DeeKahy/Pollen-Detector/report/figures/flourtest-green-crop.jpg

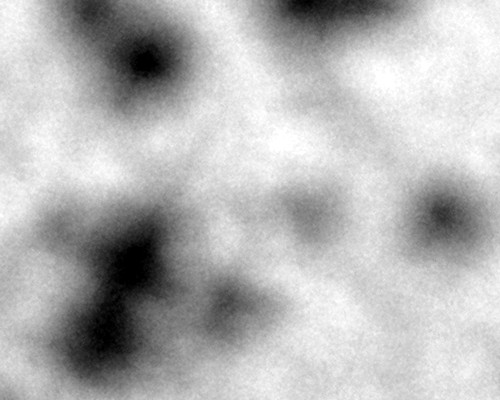
report/figures/flourtest-green-crop.jpg
