DeeKahy/Pollen-Detector/report/chapters/1.0-introduction.tex

\chapter{Introduction}\label{ch:introduction}
% Draft by Claude from the earlier introduction and our notes, edit freely.
% Red text: \fillin = write or decide now, \future = can only be done later.

Pollen allergy affects a large share of the population. For many people the symptoms follow
the day-to-day amount of pollen in the air around them. In Denmark the daily pollen counts
come from two stations, one in Copenhagen for eastern Denmark and one in Viborg for western
Denmark~\cite{AstmaAllergi}. Pollen levels for other places are estimates based on the nearest
station, so they show a general trend rather than a local measurement
\fillin{source for this, e.g. the Astma-Allergi Danmark page that says so}. Pollen levels change
with local plants, terrain and weather, so a person living far from a station can have quite
different conditions from the published numbers.

\section{How pollen is measured today}

The stations use a volumetric trap of the Hirst type~\cite{Hirst1952,EN16868}. A pump pulls
air through a narrow slit onto a sticky tape on a slowly turning drum. Once a week the tape is
taken out, stained and counted by hand under a microscope by a trained person. The method is
the reference standard and works well, but it has two problems for local information:

\begin{itemize}
  \item \textbf{Cost.} The traps and the trained staff are expensive, so there are only two
  stations. \fillin{Price of a trap, with a source. Burkard does not list prices; ask Florian or
  Astma-Allergi Danmark, or find a tender document.}
  \item \textbf{Manual work.} Every count is done by a trained person, which limits how many
  samples can be analysed~\cite{Tummon2024}. \fillin{Florian told us this. Check that
  Tummon et al.\ 2024 says it, or find a better source.}
\end{itemize}

Automated monitors exist, such as the Swisens Poleno Jupiter~\cite{SwisensPoleno}. They identify
pollen without a person, but they are specialised instruments with a price far above what a
dense network can afford. Research prototypes show that cheap optics can work: Wu et
al.~\cite{Wu2018} used a phone-based microscope without a lens and deep learning to recognise
pollen and spores.

\section{Idea: a pollen monitor anyone can build}

For fine dust the problem has already been solved in a different way. Sensor.Community (started
as luftdaten.info in Stuttgart) lets anyone build a cheap particle sensor from a guide, put it
outside and share the data on a public map~\cite{SensorCommunity}. Thousands of these sensors
now give much more local data than the official stations. No similar low-cost, open approach
exists for pollen, because a particle counter cannot tell pollen types apart.

Our idea is to do the same for pollen. The device should be cheap enough (around 100 to 150
euro) and simple enough that anyone can build one from a guide. Like the reference trap it
catches particles on sticky tape, but instead of a person with a microscope, a camera takes
pictures of the tape and software counts the pollen by type.

We see two kinds of users:

\begin{itemize}
  \item \textbf{People and communities} who build a station at home. All stations send their
  counts to a shared server, which can combine them into a local pollen map or forecast, like a
  weather forecast.
  \item \textbf{The people running the current stations}, who could set up some of our stations
  around the country. Each station should hopefully only need a new roll of tape every few weeks or months,
  and a check against a reference trap now and then to stay calibrated.
\end{itemize}

We think all of it should be free: the design, the software and the data. The software is
open source (AGPL-3.0) and the 3D models are public domain (CC0).
\fillin{Licence for the report, photos and collected data?}

This project builds on an earlier open-source pollen detector by
\fillin{Florian's full name and reference}. We designed our own 3D-printed parts from scratch,
to make the device easier to build, but the electronics and the basic way it works (a fan, a
tape moved by a stepper motor, and a Raspberry Pi camera) follow his design. The main
addition so far is a colour LED for lighting the tape.

\section{Research question}\label{sec:research-question}

We want to find out whether this is possible at all, and how far it can go. Our main question is:

\begin{quote}
\textit{How far can a cheap, open, self-built device go towards automated pollen monitoring
that anyone can build?}
\end{quote}

To answer it we split it into smaller questions:

\begin{enumerate}
  \item Can the device catch pollen-sized particles from the air on tape?
  \item Can a cheap camera without a lens show those particles well enough to recognise them?
  \item What does a station cost, and how much upkeep does it need (tape, cleaning, calibration)?
\end{enumerate}

\section{This report}

The project runs over two semesters. This report covers the first semester: the physical
device, the electronics, the first imaging tests and the control software. Next semester a
second report covers recognising pollen in the pictures, and the two reports will be turned
into a paper.

Chapter~\ref{ch:prototype} describes the prototype as it is now, what we did and why.
\fillin{Add the remaining chapters when they exist (discussion, conclusion).}
