DeeKahy/Pollen-Detector/report/frontmatter/titlepages.tex

\pdfbookmark[0]{English title page}{label:titlepage_en}
\aautitlepage{%
  \englishprojectinfo{
    Pollen Detector %title
  }{%
    \fillin{Semester theme} %theme
  }{%
    \fillin{Fall semester 2026} %project period
  }{%
    \fillin{Group} % project group
  }{%
    %list of group members
    Lennart Diego Kahn\\
    Allias Ghorbani
  }{%
    %list of supervisors
    \fillin{Florian, full name}
  }{%
    1 % number of printed copies
  }{%
    \today % date of completion
  }%
}{%department and address
  \textbf{Electronics and IT}\\
  Aalborg University\\
  \href{http://www.aau.dk}{http://www.aau.dk}
}{% the abstract
  \fillin{Abstract. Write it last: the problem, what we built, what we found, what comes next.}
}

\cleardoublepage
{\selectlanguage{danish}
\pdfbookmark[0]{Danish title page}{label:titlepage_da}
\aautitlepage{%
  \danishprojectinfo{
    Pollendetektor %title
  }{%
    \fillin{Semestertema} %theme
  }{%
    \fillin{Efterårssemestret 2026} %project period
  }{%
    \fillin{Group} % project group
  }{%
    %list of group members
    Lennart Diego Kahn\\
    Allias Ghorbani
  }{%
    %list of supervisors
    \fillin{Florian, fulde navn}
  }{%
    1 % number of printed copies
  }{%
    \today % date of completion
  }%
}{%department and address
  \textbf{Elektronik og IT}\\
  Aalborg Universitet\\
  \href{http://www.aau.dk}{http://www.aau.dk}
}{% the abstract
  \fillin{Resumé (dansk version af abstract)}
}}
