DeeKahy/Pollen-Detector/hardware/tape-deck/renders/tower_back.png

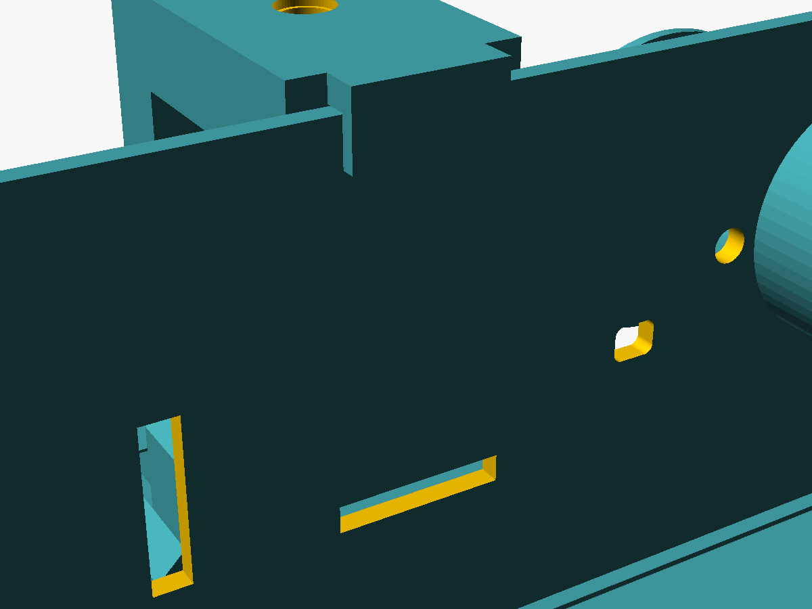
hardware/tape-deck/renders/tower_back.png
