DeeKahy/Pollen-Detector/iterations/v0-concept/camera-settings-2026-10-26/pictures/05.jpg

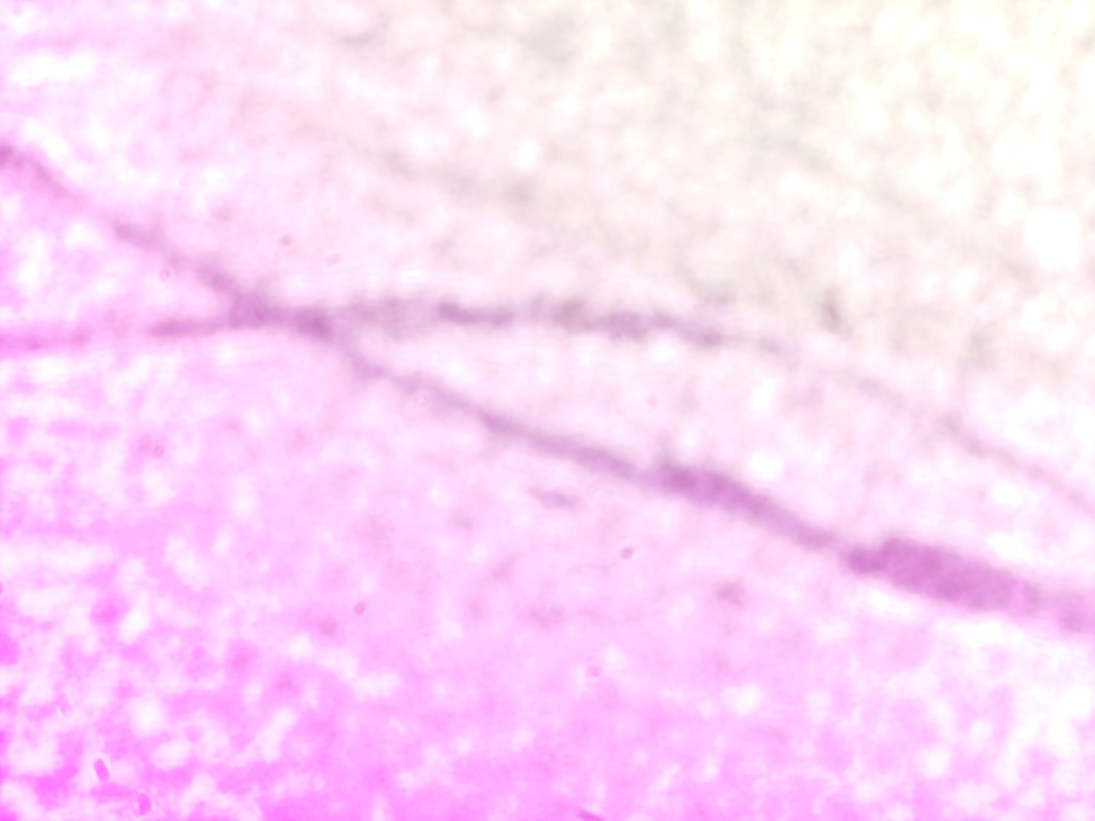
iterations/v0-concept/camera-settings-2026-10-26/pictures/05.jpg
