DeeKahy/Pollen-Detector/hardware/bom.md

# Parts list

Prices are rough, to give an idea of the total. Shop around.

## Electronics

| Part | How many | About | Notes |
|---|---|---|---|
| Raspberry Pi 3 B+ | 1 | €40 | A Pi 4 or 5 also works |
| Raspberry Pi HQ Camera (IMX477) | 1 | €55 | Used without a lens |
| Camera ribbon cable | 1 | | Comes with the camera. Longer ones (30-50 cm) are sold separately |
| 28BYJ-48 5 V stepper motor + ULN2003 driver board | 1 | €4 | Usually sold together |
| 5 V fan (brushless) | 1 | €5 | We use a JZK sleeve bearing fan |
| Logic-level N-MOSFET (IRLZ44N or AO3400) | 1 | €1 | Switches the fan. Not the blue IRF520 boards |
| 220 Ω resistor | 1 | | Fan MOSFET |
| 100 kΩ resistor | 1 | | Fan MOSFET |
| 47 Ω resistor | 1 | | LED (use 150 Ω for a red or green LED) |
| 1N5819 or 1N4148 diode | 1 | | Across the fan |
| White 5 mm LED | 1 | | |
| 5.1 V 2.5 A micro USB power supply | 1 | €10 | Use a proper one. Weak supplies make the Pi crash |
| microSD card, 32 GB or more | 1 | €10 | |
| Breadboard and jumper wires | | €5 | For the prototype |
| BME280 sensor (optional) | 1 | €5 | Logs temperature and humidity |

A small resistor kit with all values is cheap and handy.

## Other parts

| Part | How many | About | Notes |
|---|---|---|---|
| Clear tape, 12-19 mm wide | 1 roll | €3 | "Crystal clear", not frosted |
| PETG filament | ~200 g | €5 | PLA is fine for indoor testing |
| M3 screws, nuts or heat-set inserts | a few | €3 | |
| M2.5 screws and standoffs | 8 | €2 | For the Pi and camera board |
| 608 bearings (optional) | 2 | €2 | For smooth tape spools |

**Total: about €135-150**, not counting the 3D printer.
