DeeKahy/Pollen-Detector/hardware/tape-deck/stl/frame.stl

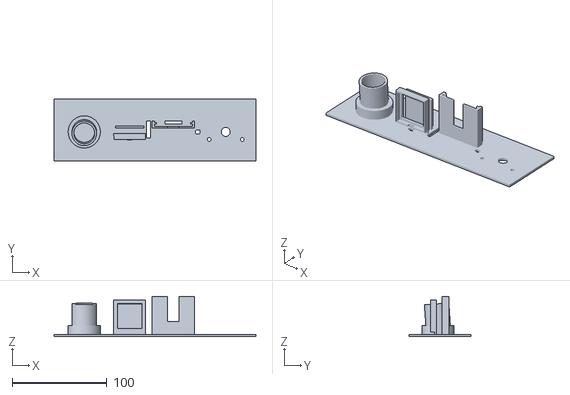
[picture p5: CAD file, 2026-11-10]
hardware/tape-deck/stl/frame.stl
213.6 x 66.0 x 42.4
