DeeKahy/Pollen-Detector/(commit log)

2026-10-20 Add pollen detector prototype: Pi software, server, wiring and docs
    - device/: Raspberry Pi control software (stepper, fan, LED, camera,
    sampling cycle, debug web UI, hardware checks, upload queue)
    - server/: minimal server that receives pictures from devices
    - docs/: build guide, wiring diagram, resistor colours, design ideas, references
    - hardware/: parts list, place for 3D models
    - iterations/: log of each built version with photos
    - ml/: recognition plan
    Claude-Session: https://claude.ai/code/session_01DpdwSijvSsaczv5Gat6Yp4
2026-10-21 Add guide for connecting to the Pi over a direct cable
2026-10-21 Cable guide: stop NetworkManager from shutting eth0 down without DHCP
2026-10-26 Speed up live preview
    Downscale the preview by pixel skipping instead of a full PIL resize
    (about 0.16 s instead of 0.8 s on a Pi 3), and fetch the next frame as
    soon as the last one loads instead of every 2 s. Shows time per frame.
2026-10-26 Add progress bar to live preview
    The bar fills towards 90 % over the last frame's time and completes
    when the image arrives. Works for single refreshes and live mode.
2026-10-26 Notes, more camera settings and delete for captures
    - Every capture gets a JSON file next to the image with the note, all
    camera settings and what the sensor reported, written to be easy for
    people and AI tools to read.
    - Web UI: note box for the next manual picture, edit notes later,
    delete pictures (image, thumbnail, JSON, DNG and database row).
    - More camera settings in the web UI: white balance and colour gains,
    brightness, contrast, saturation, sharpness, noise reduction, LED
    settle time, DNG. Kept across restarts.
    - Fix: captures could use an old frame from before a settings change
    or before the LED came on. Now waits for a fresh frame and skips
    frames until the exposure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
2026-10-26 Add camera settings test pictures (2026-10-26)
    23 pictures with one camera setting changed at a time: room light vs
    LED in a dark room, plus two own tests. Each has a 1500 px JPEG, a 1:1
    crop from the middle and the JSON with note, settings and what the
    sensor reported. Full-size originals stay out of git (pi-backups/,
    now ignored).
2026-10-27 Report: imaging tests and web UI iteration 3
    Draft of the camera settings tests (two series, room light vs blue LED)
    with figures, a settings table and placeholders (red in the PDF) for
    describing the images. Adds Web UI iteration 3 and empty slots for the
    next test round and hardware iteration 7.
2026-10-27 Nix dev shell, and skip the report build when the report is unchanged
    - flake.nix + .envrc: one shell with Python for the device software
    (mock mode) and server, and TeX Live with latexmk for the report.
    - Report workflow: 'build' is a required check, so the job still runs
    on every PR, but it skips the LaTeX build and the PDF comment when
    nothing in report/ or the workflow changed.
2026-10-27 Report: use the real test findings in the imaging tests
    - IR-cut filter was in place; 11.5 mm gap between tape and sensor; LED
    about 30 cm above the tape; a light brown hair as test object.
    - Figures now show whole pictures where the hair is visible: best of
    each series (#09, #21), greyscale under both lights (#09, #19), and
    one full-resolution crop to show the blur from the gap.
    - #23 was clipped to pure blue, so it is no longer called the best guess.
    - What we learned: room light and greyscale worked best, few usable
    blue LED pictures, pure blue only reaches one in four pixels.
2026-10-27 Document the RGB LED, the IR filter removal and the first camera results
    - docs/wiring.md: common-anode RGB LED on GPIO24/25/5 (active low),
    long leg to 3.3V pin 17, resistors 220/100/100 ohm, measured forward
    voltages, why it glows faintly at boot. Notes that wiring.svg and the
    software still assume the old single LED.
    - CLAUDE.md: hardware status, first imaging results, new decisions,
    dev shell, and next steps (RGB LED in software, coverslip).
2026-10-28 RGB LED support: colour wheel, PWM dimming, calibration, pulse and auto setup
    - Common-anode RGB LED on GPIO24/25/5 (active low), PWM dimming at 1 kHz.
    - Web UI: colour wheel, intensity, RGB boxes, presets, on/off.
    - Optional LED calibration against the camera, with progress bar.
    - Pulse effect (breathing + slow hue cycle); pictures pause it.
    - Auto setup: tries each colour, sets exposure, keeps the sharpest.
    - Every capture records the LED colour and pin duties.
    - hwtest, wiring checks, wiring diagram and docs updated (blue now 47 ohm).
2026-10-28 Report: restructure intro and prototype chapter, shorten imaging tests
    - Authors, Master's project, supervisor placeholder.
    - Introduction: problem, vision, research question and sub-questions, credit to Florian.
    - 'Iterations' replaced by 'The prototype so far' (what we did and why).
    - Imaging tests cut down to Test 1 (11.5 mm) and Test 2 (about 1 mm) with the room light picture.
    - Control software section: overall functionality and why.
    - Red placeholders: \fillin (write now) and \future (later work).
2026-10-28 Report: document the supervisor review flow with the supervisor-reviewed branch
2026-11-05 Report: plan for user studies (interviews, written questions, build test)
    New chapter 2 (users and their needs) and chapter 4 (testing with users),
    both marked as plans. Interview guide, questions for Astma-Allergi Danmark
    and the build test plan in the appendices. Two new research sub-questions.
    Chapters renumbered so the order is: intro, needs, prototype, testing,
    conclusion. New planned environment makes a whole block red.
2026-11-05 Report: NeoPixel, LED tower and flour test (Test 3)
2026-11-05 Report: green LED picture in Test 2, LED described as one LED from a light string
2026-11-05 Report: the smaller hole is 1.5 mm
2026-11-10 NeoPixel string as the LED: SPI driver, pixel choice, current limit
2026-11-10 Hardware: tape deck prototype frame (OpenSCAD, STLs, renders)
